nasianikolova/Cubi-2/README.md

# Cubi 2

**A SpaceInClass project designed by Athanasia (Nasia) Nikolova**

Cubi 2 is a self-balancing cube for the classroom. Three reaction wheels, one on each of three faces, and the battery sit inside a printed box; the box rides in a cage of 12 beams, with a rolling sphere around it. It is designed so that high-school students can build it and work with it to learn physics, mathematics, programming and space on a real machine.

Cubi 2 is designed in parametric code: one model makes the mechanical build, the three electronics boards, every cable and the printed documents. The numbers - dimensions, clearances, screws, inserts, print settings, weights - come from tests and from real builds and prints, not from theory alone.

This repository holds the **CAD files** (STEP and STL), the **build guides** (PDF) and the **Cubi 2 app** (code). The parametric model itself is not part of this repository.

> **This repository is a record of what was designed and built, not an instruction to build it.** Before you use anything here, read `DISCLAIMER.md` and `RESPECT.md`.

## Cubi 1 and Cubi 2

Cubi 2 grows out of Cubi 1, the first cube, built by a team at a space program in Sofia, 2026. The idea and the whole mechanical design of that cube are Athanasia Nikolova’s: she conceived it, designed it, made the CAD, 3D-printed every part, and assembled the cube, mounting the motors and the boards herself. Her teammates made the wiring and the electronics boards, wrote the software, and brought the cube into operation.

Cubi 1 brought the ideas that Cubi 2 keeps:

- the **open frame** - a cube made of edges only, open on every face;
- the **beams turned by 45 degrees**, like the roof beams of the old houses and the old Orthodox churches of Veria;
- the **reaction wheels**.

Cubi 2 adds:

- an **inner layout built around a perfect balance of the weight**, horizontally and vertically;
- the **gyroscope (IMU) and the battery on the vertical axis** - the main diagonal the cube balances on;
- **the routing of the cables**: every wire on its own road, in order, hidden under the boards;
- an attempt at **aesthetics alongside the engineering**.

## SpaceInClass

SpaceInClass is an initiative by Athanasia Nikolova. She first presented it at the **CASSINI Space Camp 2025** in Thessaloniki, Greece, where she and her team designed and assembled an 8U CubeSat model and planned its mission. The aim of SpaceInClass is to bring real space engineering into schools through *SpaceLabs*, where students build, program and operate their own hardware. Cubi 2 is one of the projects made for the SpaceLabs.

SpaceInClass is written entirely in English and is open to every school in the world. It is an independent initiative. It is not affiliated with or endorsed by the CASSINI Space Camp or its organizers.

### Why

> I want to bring knowledge into schools in a different way: more fun, with practical work while students learn the theory. I want to bring collaboration, so that already at school each of us can find the field they are good at. Students do not need to know everything. They can specialize, build teams and work together.
>
> Many children are bored in class. They cannot concentrate, they are not interested. Maybe I was like that once. Maybe these children are out there.
>
> I am waiting for ideas for more projects in SpaceInClass.
>
> - Athanasia Nikolova

## The original idea

Both Cubi 1 and Cubi 2 stand on the shoulders of the **Cubli**, the cube that can jump up and balance on a corner, created by scientists of the Institute for Dynamic Systems and Control at ETH Zurich, Switzerland. Their work showed that a cube with three reaction wheels can stand up by itself and balance on an edge or a corner. Cubi takes that idea into the classroom: printable, built by students, and designed with its own architecture.

- M. Gajamohan, M. Merz, I. Thommen, R. D'Andrea, *"The Cubli: A Cube That Can Jump up and Balance"*, IEEE/RSJ International Conference on Intelligent Robots and Systems (IROS), 2012, pp. 3722-3727.
- M. Gajamohan, M. Muehlebach, T. Widmer, R. D'Andrea, *"The Cubli: A Reaction Wheel Based 3D Inverted Pendulum"*, European Control Conference (ECC), 2013.

Cubi 2 is an independent project: it is not affiliated with or endorsed by the original authors or ETH Zurich.

## What has been tested

The printing, the assembly and the documentation of Cubi 2 have been tried out on real builds: the parts were printed, the cube was put together, and the guides were used to do it.

The operation has been tested too. In **29 recorded runs** on 22, 23 and 26 October 2026, Cubi 2 went from **1.4 seconds to 17.9 minutes** balancing on its corner. The 17.9-minute run was stopped by hand, with the cube still standing. Every run is kept in `Code/cubi2app/data/runs.json`.

The first tests of the **sphere** are done: it holds on its own and made a first short move.

The numbers in this repository come from those builds and tests, but they may still contain errors; check them against your own parts and printer.

### What the tests changed

- **The battery column.** The gyroscope (IMU) now sits inside a stiff plate, so the small moves of the battery no longer reach it.
- **The standoff at corner 0.** It broke when Cubi fell from my hands; the new one has ribs.
- **The hanging plate** (`CAD/Prints/hang_plate`). Cubi hangs from corner 0 and settles, and the app reads the new balance point.

### Next version

- The USB sockets of the boards reachable from outside the cube.
- A place for balance weights.

## A different direction: the sphere

The Cubli stands up by braking its wheels suddenly. **Cubi has no brakes.**

The first big change is the **sphere**. Cubi shifts the original purpose: it aims at **motion**, not only at standing up and balancing. The sphere is the perfect shape, and it is where I intend to experiment the most. **Cubi 2 has the sphere.**

## What I intend

This is a statement of intentions, not of results: I announce no discovery.

- I will **experiment** with the real cube and run **simulations** of it.
- The aim is to find out whether these ideas can be **useful in space applications**.
- Along the way, the research is meant to be a mix of **play, tests, failures, new knowledge from theory** - and perhaps a few successes.
- The project is planned to keep **students and STEM clubs** busy for **one academic year**.
- **SpaceInClass** will feature the good ideas that come out of this work on its page.

---

## What is where

```
CAD/
  Prints/      the parts that were PRINTED here - box, cage corners and beams,
               cover, reaction wheel, sphere arcs and connector, battery mounts,
               magnet carrier, cable clamps, standoffs, hanging plate
               (STEP and STL, as printed)
  Hardware/    what was BOUGHT and BUILT - motors, motor drivers, IMU, MCU board,
               battery connectors, spacers, and the three electronics boards
               that were soldered (STEP)
               SOURCES.txt = where each third-party model comes from + its license
Code/
  cubi2app/    the Cubi 2 app - Simulation and Live, in plain JavaScript
               (how to start it: Code/cubi2app/README.md)
Documents/     the build guides and the materials list (PDF), and the version history
```

The full assemblies (the whole cube, and the cube with all its cables) are larger than GitHub allows for one file (over 100 MB); they will be shared separately.

## How the documents are made

The build documents (parts lists and step-by-step guides) record how the cube was built here. Their layout and written text were produced with the help of artificial intelligence, working from the model and from the real builds; the mechanical design, the parametric model, the color system and the engineering decisions are my own. Care went into the teaching side of them:

- a **color code** that stays the same in every document - each board, wire and insert size has its own color, chosen so that students with low vision or color-blindness can tell them apart as well;
- **images and diagrams** drawn from the real 3D model, with real colors, so that what students see on paper is what they hold in their hands;
- one action per page, short steps and readable contrast, so that every student can follow them.

The aim is simple: to make the engineering **easier to understand** for students. The documents are reviewed, but they may contain mistakes - read them together with `DISCLAIMER.md`.

## Design rules

These are the rules the project follows, and the state the files are in:

- The **printed parts** in `CAD/Prints/` are the parts as printed; the parts in `CAD/Hardware/` keep their original colors.
- The **cage and the box are fixed**: they are already printed, so no later change moves them, not even by 0.001 mm.
- **Cables** run only on the cable roads: under the boards, along the three edges at corner 0, and on the sides of the corner-0 triangle. Power wires lie under the signal wires; no wire crosses another on a board; every wire gets under a board across a side, between that side's two standoffs.
- **Documents** have one action per page, real colors and readable contrast, also for low-vision students.
- Everything is in English.

## Units and frames

Millimeters; Corner 0 of the box is the origin; the three motor faces are x, y and z, with the wheels toward -x, -y and -z.

## License

Cubi 2 is **free for everyone**, as long as the name **Cubi 2** and its authors are credited.

- **Code** (the Cubi 2 app, and any code added to the project): **MIT** - see `LICENSE`.
- **CAD, drawings, documents, images**: **CC BY 4.0** - see `LICENSE-CAD.md`. Credit line: *Based on Cubi 2 by Athanasia Nikolova / SpaceInClass, CC BY 4.0.*
- **Third-party models** in `CAD/Hardware/` keep their own licenses - see `CAD/Hardware/SOURCES.txt`.

## Disclaimer, respect and safety

Cubi 2 is recorded for high-school students working **under the supervision of a teacher or mentor**.

- `DISCLAIMER.md` - no warranty, what the project is not, and who is responsible for what.
- `RESPECT.md` - how the project asks to be treated, and the safety note (battery, spinning wheels, soldering).

## Credits

Design: Athanasia Nikolova, for SpaceInClass.
