nasianikolova/Cubi-2/DISCLAIMER.md

# Disclaimer

Cubi 2 is an educational, open project by Athanasia Nikolova / SpaceInClass. This page explains what the project is, what it is not, and who is responsible for what. It does not replace the licenses (`LICENSE`, `LICENSE-CAD.md`); where anything here and the licenses differ, the licenses apply.

## No warranty

Everything in this repository — CAD files, drawings, documents, images and code — is provided **"as is", without warranty of any kind**, express or implied, including fitness for a particular purpose. To the extent permitted by law, the author is **not liable** for any damage, injury, loss or cost arising from the use, misuse or inability to use this material, whether or not it was built or used as described.

## A record, not an instruction

This repository **shows what was designed, printed and built**. It is a record and an example, not an invitation, a recommendation or an instruction to anyone to reproduce it.

- Nothing here tells you to build a Cubi 2, to buy any component, to use any battery, tool, material or setting, or to carry out any step.
- The steps in the build documents describe **how it was done here**, with these parts, this printer and this filament, under supervision. They are not a direction to do the same, and they are not a claim that doing the same is safe.
- The decision to build, charge, power or operate anything based on this material is taken **freely and independently** by the person who builds it — and, where students are involved, by the supervising adult, school or organization. That decision, and everything that follows from it, is theirs.
- Where a step would be unsafe in your setting, with your parts or with your students: **do not do it.** Your own judgment, and the rules of your school and country, come before anything written here.

## What Cubi 2 is not

- **Not a certified or finished product.** It is not CE marked, not tested against any safety or EMC standard, and not approved for sale, hire or distribution as a product.
- **Not a toy.** It is a teaching machine, recorded for high-school students working **under the supervision of a teacher or mentor**.
- **Not space-qualified.** The project explores ideas that may one day be useful in space applications; nothing here is flight hardware or validated for space, and no such claim is made.
- **Not a scientific result.** The section "What I intend" in the README is a statement of intentions. No discovery is announced and no performance is promised.

## Build status

Printing, assembly and the build documents have been tried on real builds. The **operation** has been tested in 29 recorded runs (October 2026), the longest 17.9 minutes; these are tests of one cube, not a guarantee for another. Dimensions, clearances, screw and insert sizes, print settings and weights come from tests and real builds, but they **may still contain errors**. Check every number against your own parts, printer and materials before you rely on it.

Parts of the build documents are produced with the help of **artificial intelligence**. They are reviewed, but they may contain mistakes. Treat them as a record, not as an authority.

## Safety and responsibility

The safety notes in `RESPECT.md` are a summary, not a complete risk assessment. Cubi 2 involves a **6S lithium-polymer battery**, **fast spinning reaction wheels**, **soldering at high temperature**, **strong magnets**, **adhesives** and **carbon-fiber filament**. These can cause fire, burns, cuts, crushing, eye damage and inhalation of harmful particles.

- The person who builds, charges, powers or operates a Cubi 2 — and, for students, the **supervising adult, school or organization** — carries full responsibility for safe working, risk assessment, supervision, protective equipment, insurance and compliance with local rules and school policy.
- Anyone using this material must have, or be supervised by someone who has, the skills to judge whether a step is safe in their own setting.
- The supervising adult decides what each student may do.

## Third-party work

- Models in `CAD/Hardware/` come from third parties and **keep their own licenses** — see `CAD/Hardware/SOURCES.txt`. No warranty is given for their accuracy or for their fitness for this build.
- Bought components (motors, drivers, IMU, MCU board, battery, fasteners) are the responsibility of their own manufacturers. Follow their datasheets and safety instructions; where they differ from this project's documents, the manufacturer's instructions apply.

## No affiliation or endorsement

Cubi 2 is an independent project. It is **not affiliated with, sponsored by or endorsed by** ETH Zurich, the authors of the Cubli, the CASSINI Space Camp or its organizers, or any component manufacturer, institution or program named in this repository. Names are mentioned for credit and reference only.

## Changes and forks

Anyone who modifies, redistributes or builds on Cubi 2 is responsible for their own version. Please say clearly what you changed, so that no one confuses your version with the original or holds the original responsible for it. Nothing in this project implies that a modified version is safe or correct.

## Students' work

Builds, code, photos and results made by students belong to them. Nothing here claims rights over student work, and student names are published only with their permission and, for minors, their guardians' permission.

## Contact

Mistakes and safety concerns are welcome: please open an issue in this repository. They will be corrected as soon as possible, but no response time is guaranteed.

---

*Design and project: Athanasia Nikolova, for SpaceInClass.*
