nasianikolova/Cubi-2/CAD/Hardware/perfboard.STEP

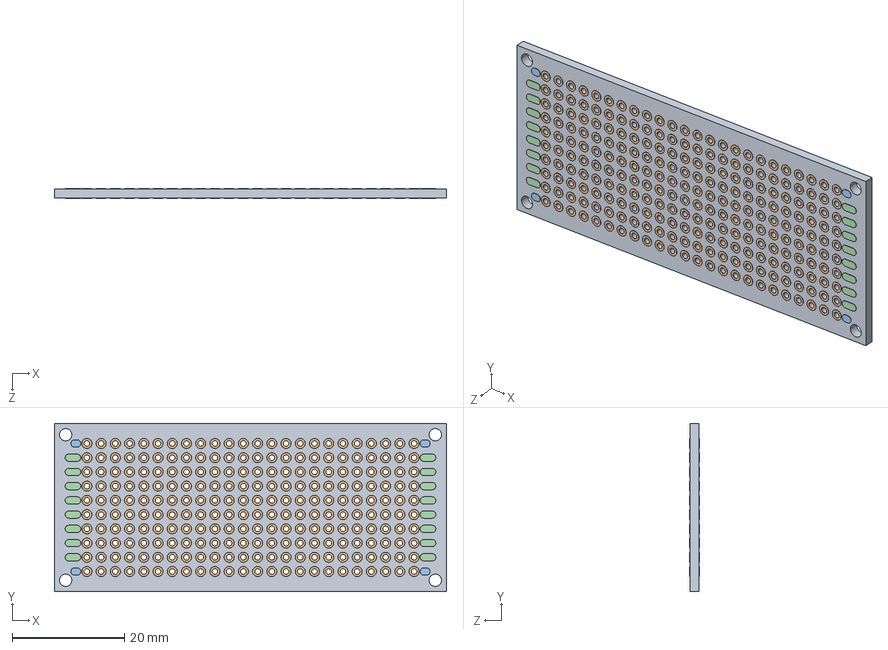
[picture p3: CAD file, 2026-10-29]
CAD/Hardware/perfboard.STEP
70.0 x 30.0 x 1.70 mm
fr4
rings_top
endpad_top_0
endpad_top_1
endpad_top_2
endpad_top_3
endpad_top_4
endpad_top_5
endpad_top_6
endpad_top_7
endpad_top_8
endpad_top_9
endpad_top_10
endpad_top_11
endpad_top_12
endpad_top_13
endpad_top_14
endpad_top_15
endpad_top_16
endpad_top_17
endpad_top_18
endpad_top_19
rings_bot
endpad_bot_0
endpad_bot_1
endpad_bot_2
endpad_bot_3
endpad_bot_4
endpad_bot_5
endpad_bot_6
endpad_bot_7
endpad_bot_8
endpad_bot_9
endpad_bot_10
endpad_bot_11
endpad_bot_12
endpad_bot_13
endpad_bot_14
endpad_bot_15
endpad_bot_16
endpad_bot_17
endpad_bot_18
endpad_bot_19
