nasianikolova/Cubi-2/CAD/Prints/hang_plate.STEP

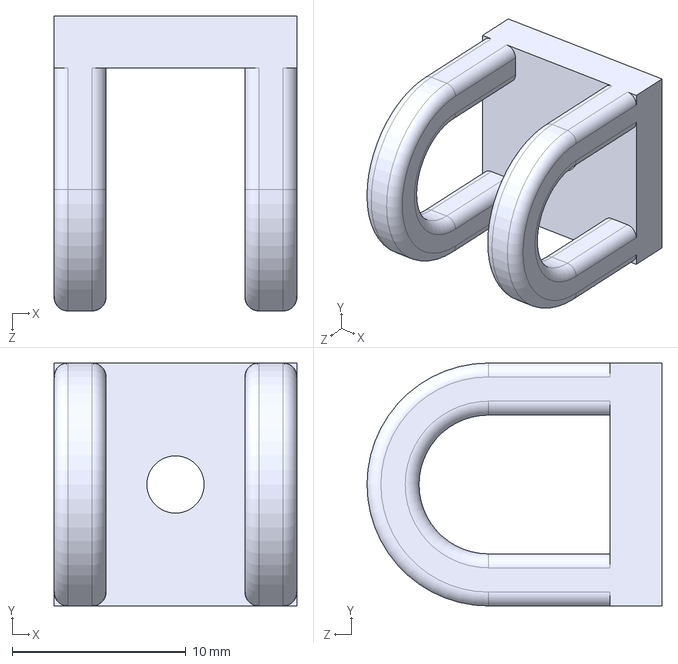
[picture p4: CAD file, 2026-10-30]
CAD/Prints/hang_plate.STEP
14.0 x 14.0 x 17.0 mm
