nasianikolova/Cubi-2/CAD/Hardware/motor_driver.STEP

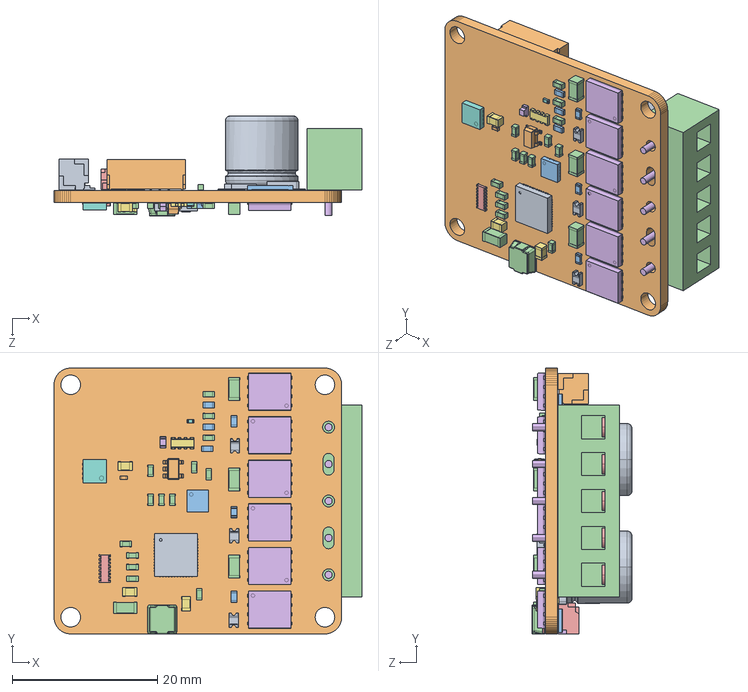
[picture p5: CAD file, 2026-10-29]
CAD/Hardware/motor_driver.STEP
42.4 x 36.6 x 13.8 mm
