nasianikolova/Cubi-2/CAD/Prints/reaction_wheel.STEP

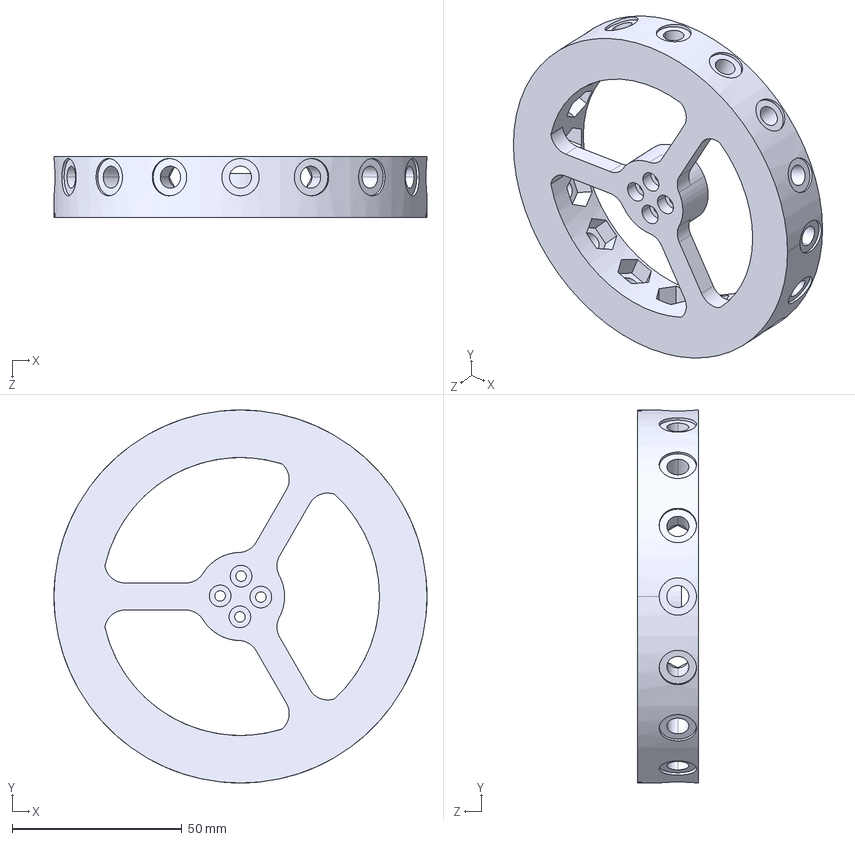
[picture p6: CAD file, 2026-10-30]
CAD/Prints/reaction_wheel.STEP
110.0 x 110.0 x 18.0 mm
