nasianikolova/Cubi-2/CAD/Hardware/motor.STEP

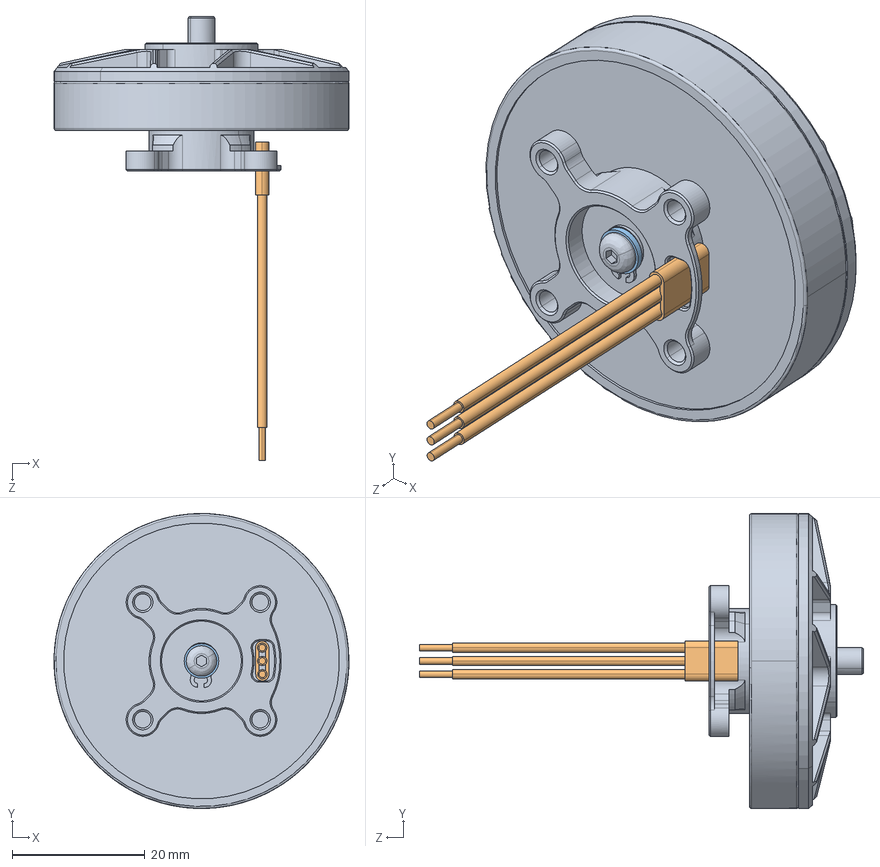
[picture p7: CAD file, 2026-10-29]
CAD/Hardware/motor.STEP
44.4 x 44.4 x 66.9 mm
leads
lead_exit_1
