nasianikolova/Cubi-2/CAD/Prints/battery_basin.STEP

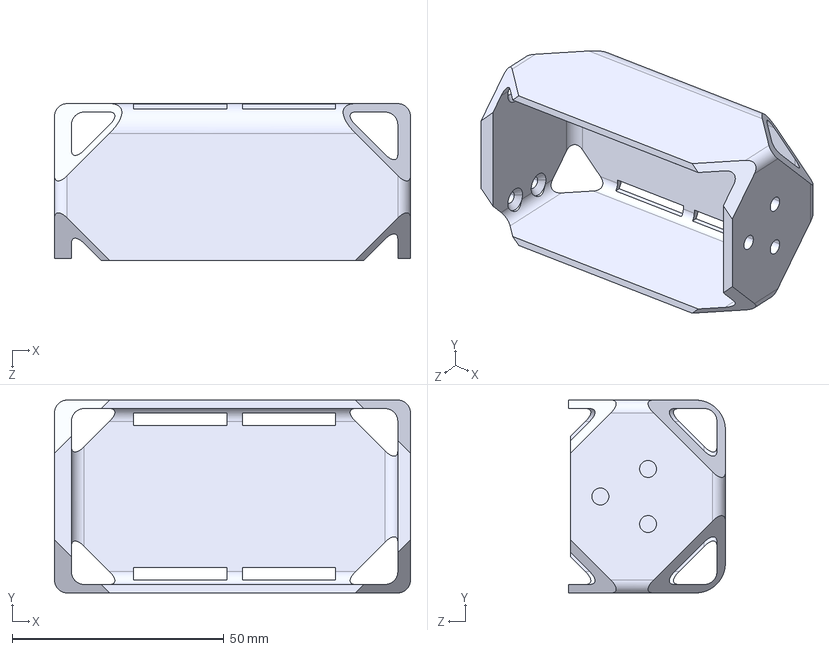
[picture p8: CAD file, 2026-10-30]
CAD/Prints/battery_basin.STEP
84.0 x 45.5 x 37.0 mm
