nasianikolova/Cubi-2/CAD/Hardware/mcu.STEP

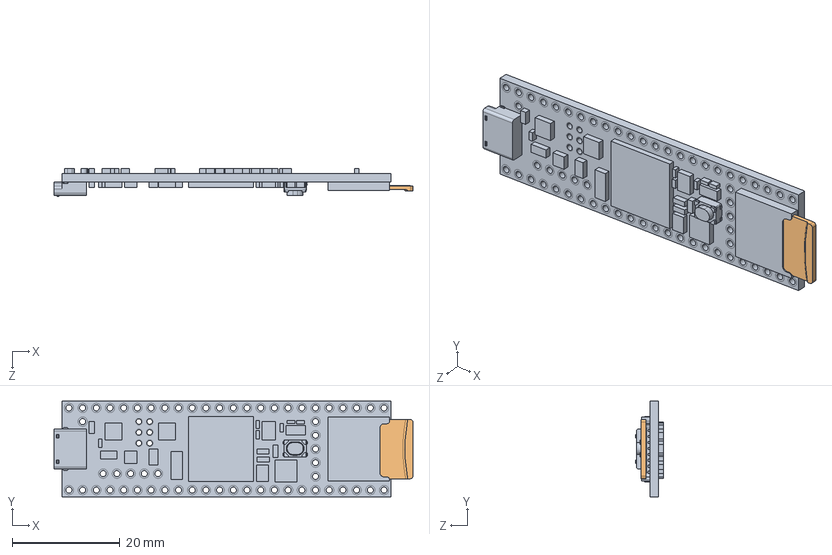
[picture p9: CAD file, 2026-10-29]
CAD/Hardware/mcu.STEP
66.6 x 17.8 x 5.27 mm
