nasianikolova/Cubi-2/CAD/Prints/clamp_x_2_base.STEP

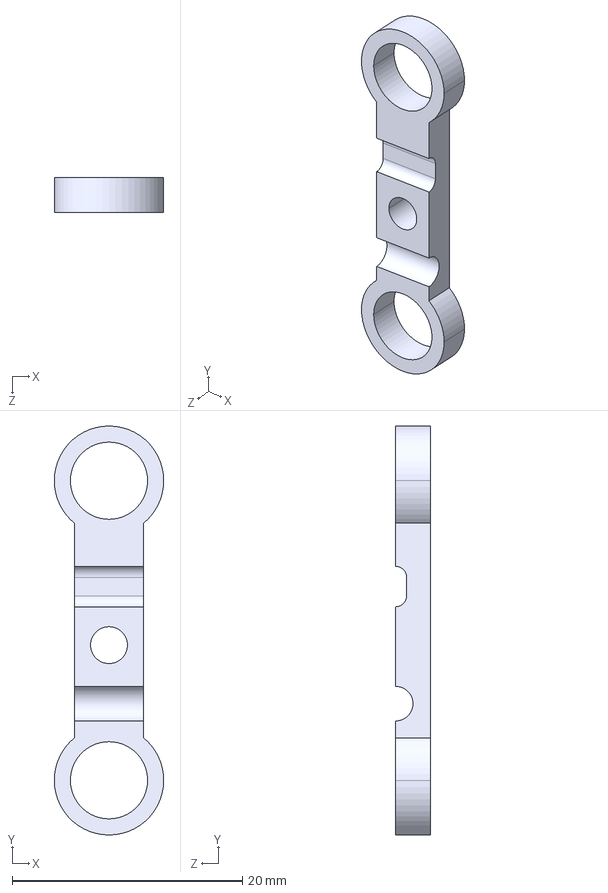
[picture p10: CAD file, 2026-10-30]
CAD/Prints/clamp_x_2_base.STEP
9.50 x 35.5 x 3.00 mm
