nasianikolova/Cubi-2/CAD/Hardware/imu.STEP

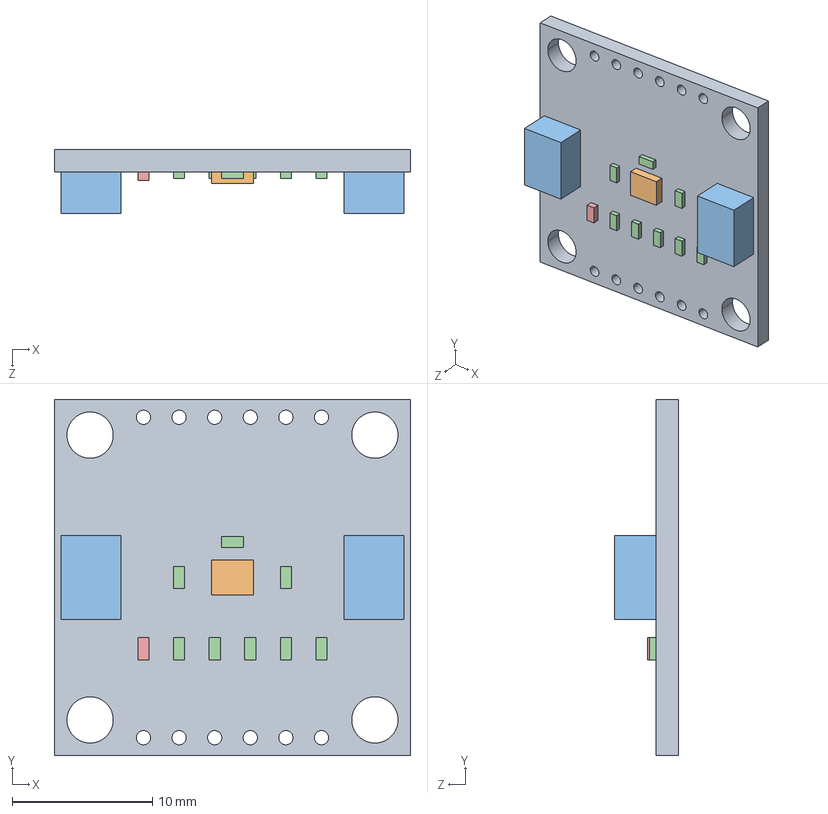
[picture p11: CAD file, 2026-10-29]
CAD/Hardware/imu.STEP
25.4 x 25.4 x 4.55 mm
pcb
U1_imu
J1_i2c
J2_i2c
R1
R2
R3
R4
R5
R6
C1
C2
D1
