nasianikolova/Cubi-2/CAD/Prints/navel.step

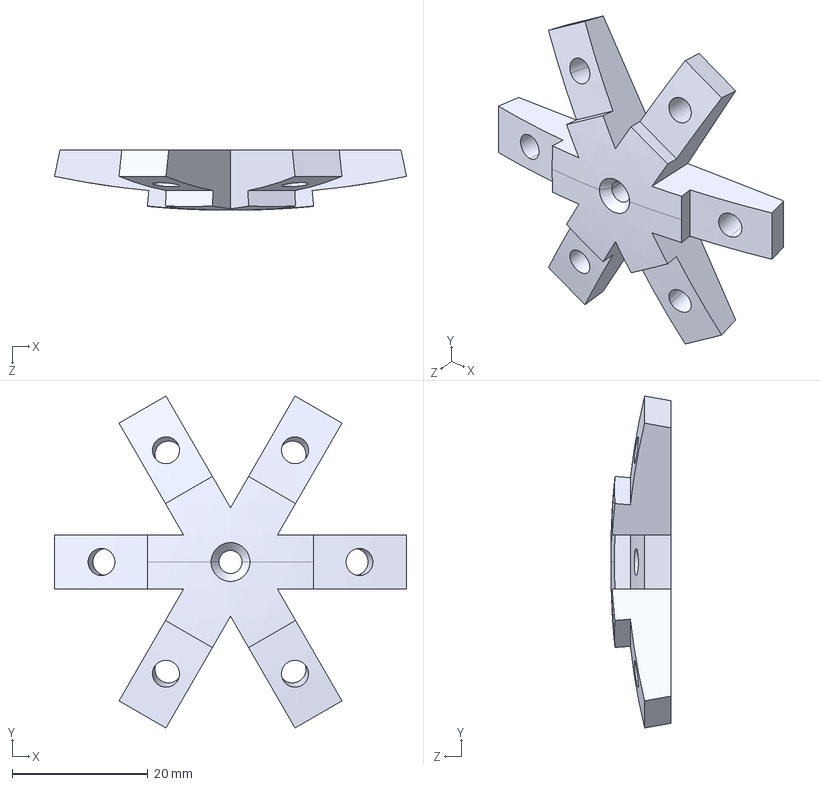
[picture p12: CAD file, 2026-10-30]
CAD/Prints/navel.step
51.9 x 49.0 x 8.90 mm
