nasianikolova/Cubi-2/CAD/Hardware/bconn_male.STEP

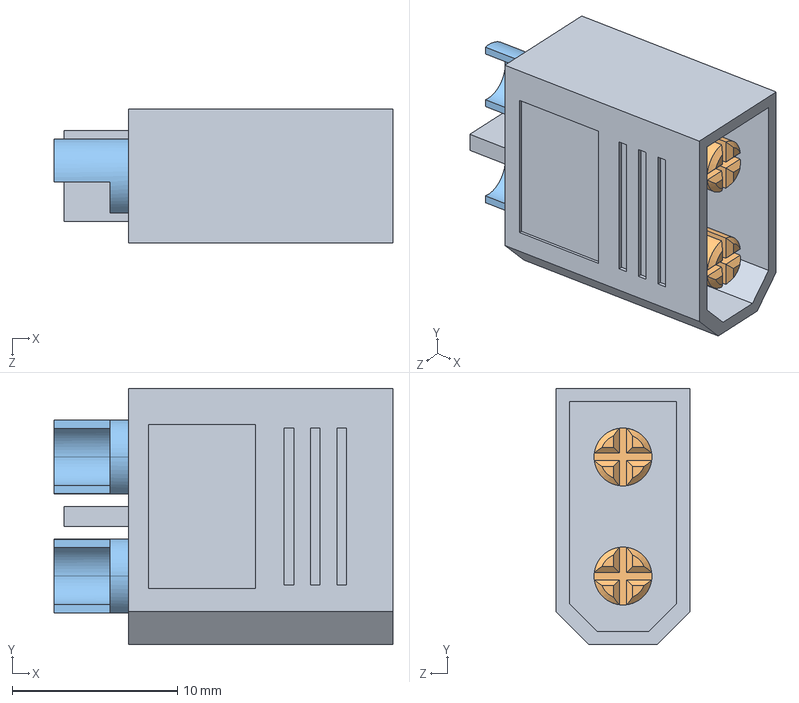
[picture p13: CAD file, 2026-10-29]
CAD/Hardware/bconn_male.STEP
20.5 x 15.5 x 8.10 mm
bconn_male_housing
bconn_male_gold_1
bconn_male_gold_2
bconn_male_gold_3
bconn_male_gold_4
