nasianikolova/Cubi-2/CAD/Prints/box_standoff.STEP

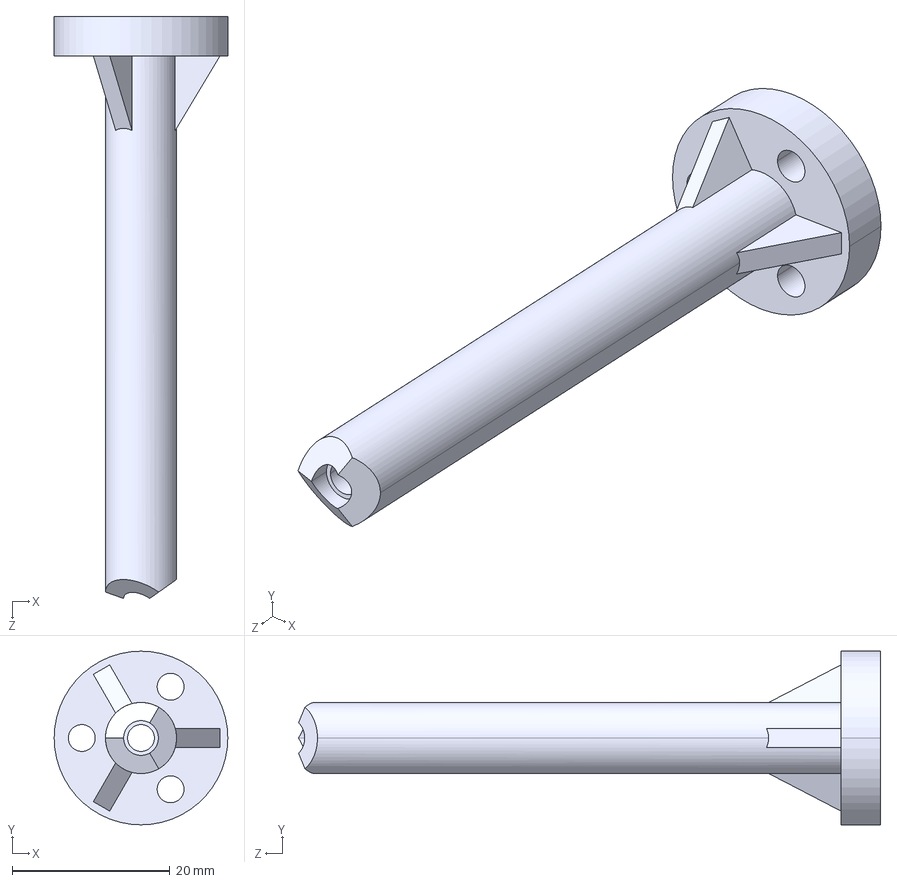
[picture p14: CAD file, 2026-10-30]
CAD/Prints/box_standoff.STEP
22.0 x 22.0 x 73.7 mm
