nasianikolova/Cubi-2/CAD/Hardware/bconn_female.STEP

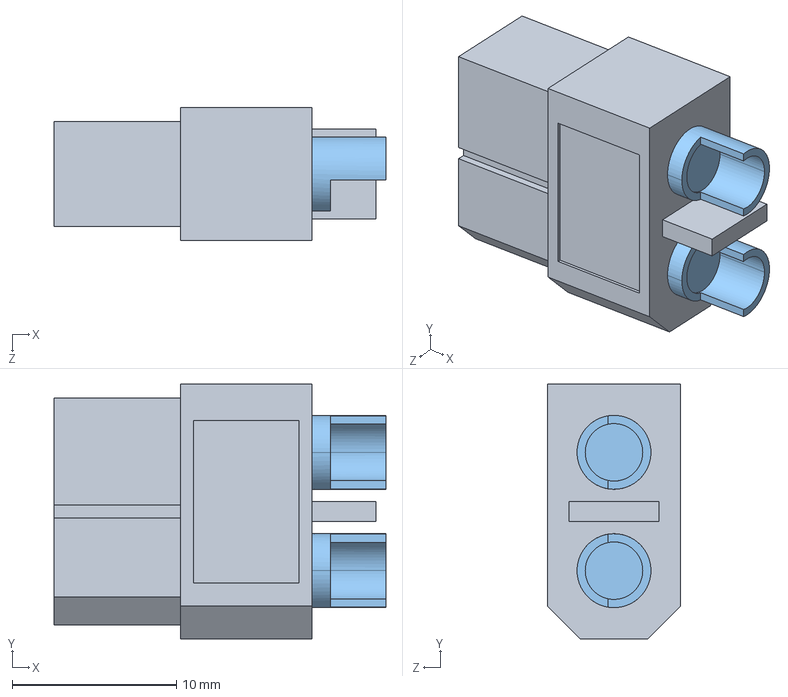
[picture p15: CAD file, 2026-10-29]
CAD/Hardware/bconn_female.STEP
20.2 x 15.5 x 8.10 mm
bconn_female_housing
bconn_female_gold_1
bconn_female_gold_2
bconn_female_gold_3
bconn_female_gold_4
