nasianikolova/Cubi-2/CAD/Prints/spacer_OD6_ID3.2_H4.STEP

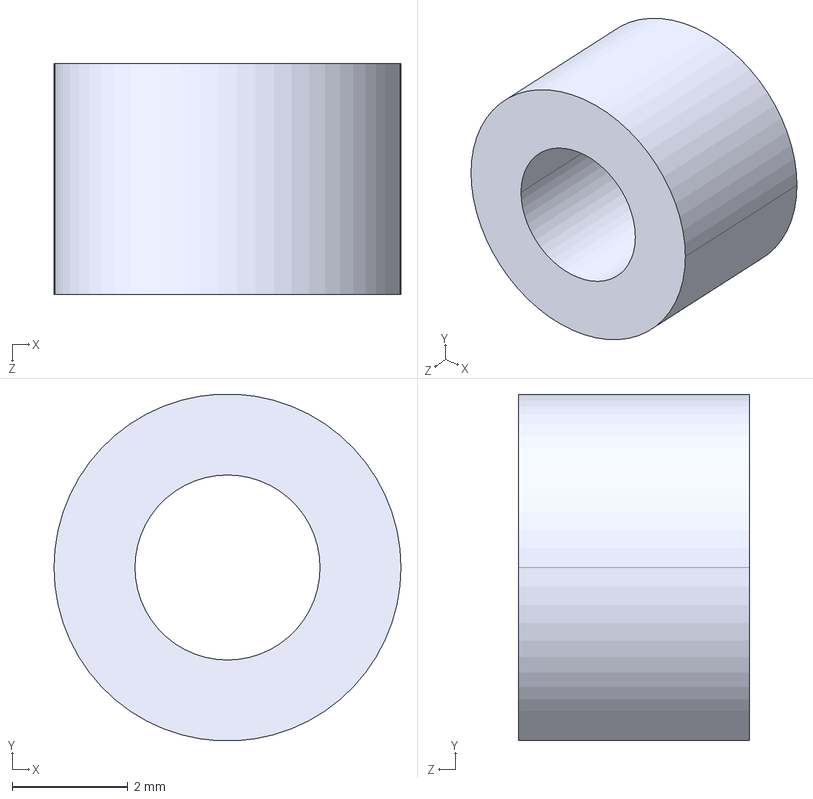
[picture p16: CAD file, 2026-10-30]
CAD/Prints/spacer_OD6_ID3.2_H4.STEP
6.00 x 5.99 x 4.00 mm
