nasianikolova/Cubi-2/CAD/Hardware/board_x.STEP

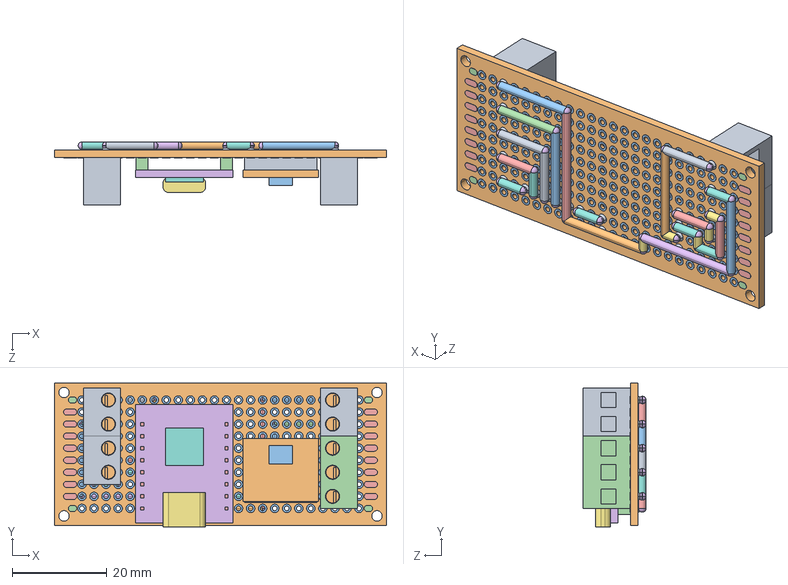
[picture p17: CAD file, 2026-10-29]
CAD/Hardware/board_x.STEP
70.0 x 30.3 x 13.4 mm
tb_w1_0
tb_w1_1
tb_w1_2
tb_w1_3
tb_w1_4
tb_w2_0
tb_w2_1
tb_w2_2
tb_w2_3
tb_w2_4
wifi_0
wifi_1
wifi_2
wifi_3
wifi_4
wifi_5
wifi_6
wifi_7
wifi_8
wifi_9
wifi_10
wifi_11
wifi_12
wifi_13
wifi_14
wifi_15
wifi_16
wifi_17
wifi_18
wifi_19
wifi_20
cantr_0
cantr_1
cantr_2
cantr_3
cantr_4
cantr_5
cantr_6
cantr_7
cantr_8
tb_e1_0
tb_e1_1
tb_e1_2
tb_e1_3
tb_e1_4
tb_e1_5
tb_e1_6
tb_e2_0
tb_e2_1
tb_e2_2
tb_e2_3
tb_e2_4
wire_0
wire_1
wire_2
wire_3
wire_4
wire_5
wire_6
wire_7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
