nasianikolova/Cubi-2/CAD/Prints/beam_tie.STEP

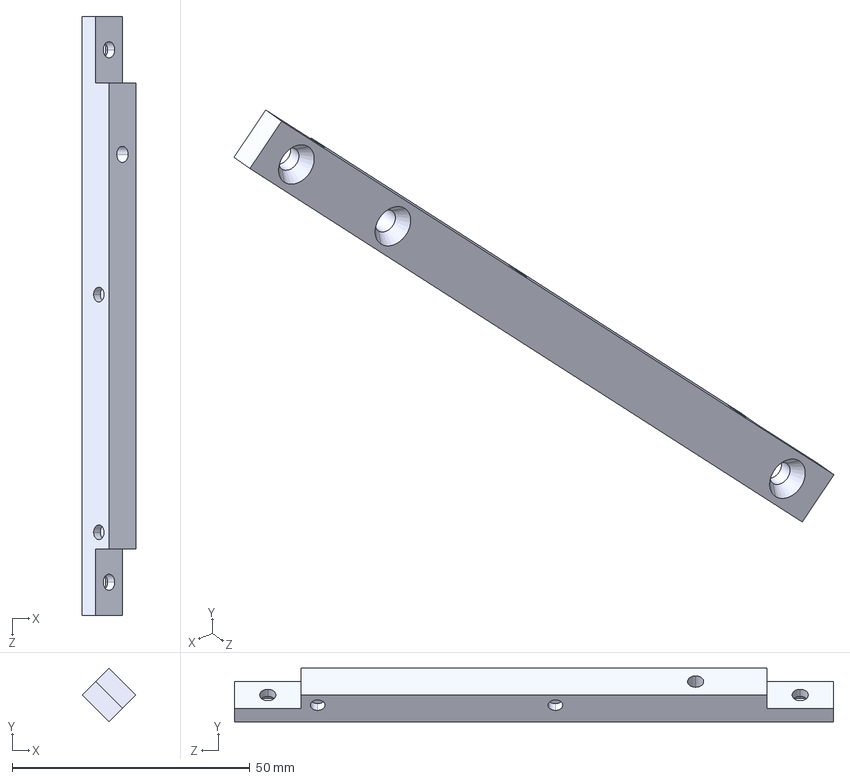
[picture p18: CAD file, 2026-10-30]
CAD/Prints/beam_tie.STEP
11.3 x 11.3 x 126.0 mm
