nasianikolova/Cubi-2/CAD/Hardware/board_y.STEP

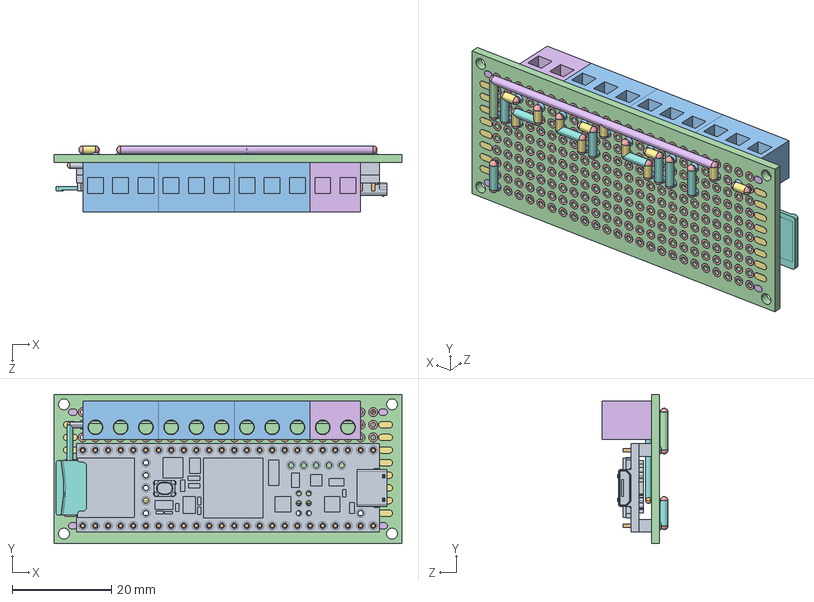
[picture p19: CAD file, 2026-10-29]
CAD/Hardware/board_y.STEP
70.0 x 30.0 x 13.4 mm
mcu_1
mcu_2
mcu_3
mcu_4
mcu_5
mcu_6
mcu_7
mcu_8
mcu_9
mcu_10
mcu_11
mcu_12
mcu_13
mcu_14
mcu_15
mcu_16
mcu_17
mcu_18
mcu_19
mcu_20
mcu_21
mcu_22
mcu_23
mcu_24
mcu_25
mcu_26
mcu_27
mcu_28
mcu_29
mcu_30
mcu_31
mcu_32
mcu_33
mcu_34
mcu_35
mcu_36
mcu_37
mcu_38
mcu_39
mcu_40
mcu_41
mcu_42
mcu_43
mcu_44
mcu_45
mcu_46
mcu_47
mcu_48
mcu_49
mcu_50
tb_a_0
tb_a_1
tb_a_2
tb_a_3
tb_a_4
tb_a_5
tb_a_6
tb_b_0
tb_b_1
tb_b_2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
