nasianikolova/Cubi-2/CAD/Prints/spacer_OD6_ID3.2_H1.step

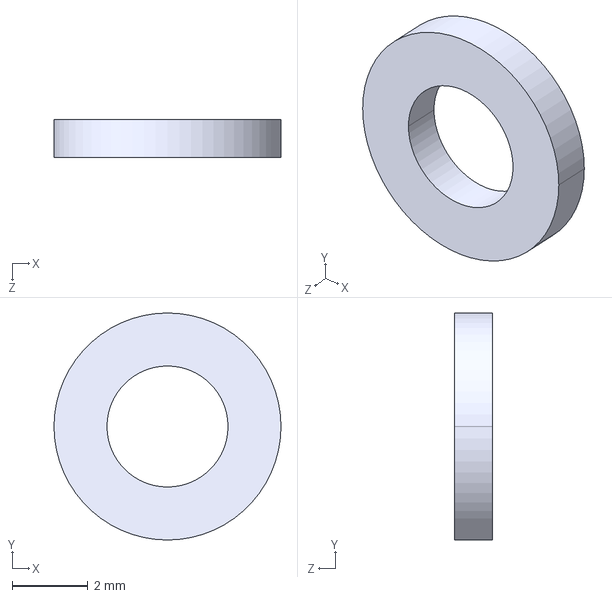
[picture p20: CAD file, 2026-10-30]
CAD/Prints/spacer_OD6_ID3.2_H1.step
6.00 x 6.00 x 1.00 mm
