nasianikolova/Cubi-2/CAD/Hardware/board_z.STEP

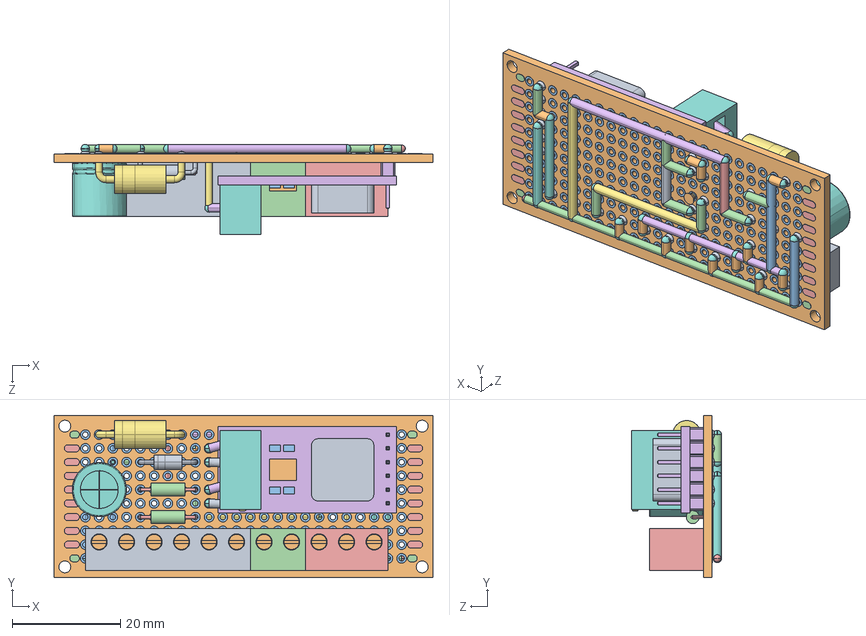
[picture p21: CAD file, 2026-10-18]
CAD/Hardware/board_z.STEP
70.0 x 30.0 x 16.7 mm
tb_mot_6p_0
tb_mot_6p_1
tb_mot_6p_2
tb_mot_6p_3
tb_mot_6p_4
tb_mot_6p_5
tb_mot_6p_6
tb_mot_6p_7
tb_mot_6p_8
tb_mot_6p_9
tb_mot_6p_10
tb_mot_6p_11
tb_mot_6p_12
tb_batt_0
tb_batt_1
tb_batt_2
tb_batt_3
tb_batt_4
tb_out_3p_0
tb_out_3p_1
tb_out_3p_2
tb_out_3p_3
tb_out_3p_4
tb_out_3p_5
tb_out_3p_6
dcdc_1_0
dcdc_1_2
dcdc_1_3
dcdc_1_4
dcdc_1_5
dcdc_1_6
dcdc_1_7
dcdc_1_8
dcdc_1_9
dcdc_1_10
dcdc_1_11
dcdc_1_12
r_100k_0
r_100k_1
r_10k_0
r_10k_1
dcdc_drop_0
dcdc_drop_1
dcdc_drop_2
dcdc_drop_3
dcdc_drop_4
dcdc_drop_5
dcdc_drop_6
dcdc_drop_7
dcdc_drop_8
dcdc_drop_9
dcdc_drop_10
dcdc_drop_11
dcdc_drop_12
wire_0
wire_1
wire_2
wire_3
wire_4
wire_5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
