nasianikolova/Cubi-2/CAD/Prints/magnet_carrier.STEP

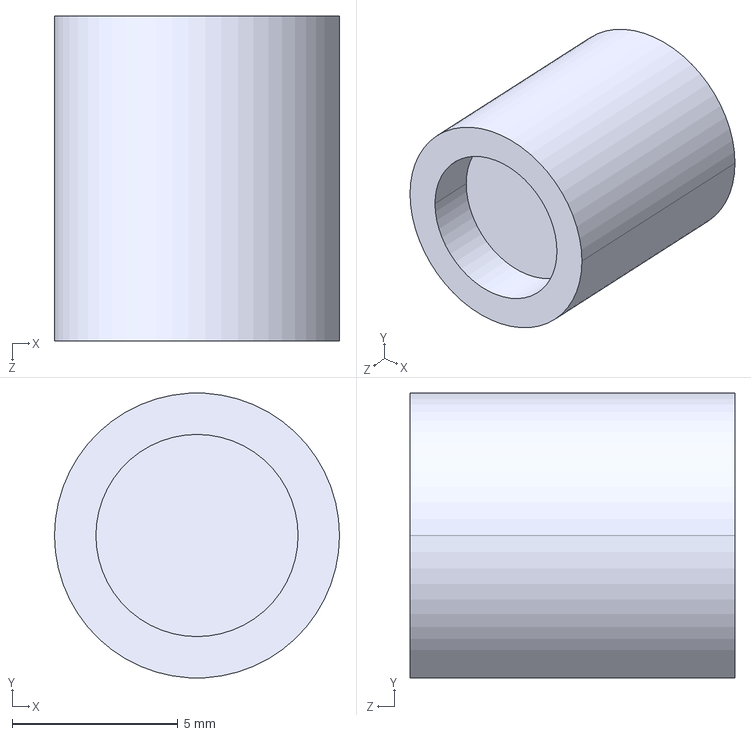
[picture p22: CAD file, 2026-10-30]
CAD/Prints/magnet_carrier.STEP
8.60 x 8.59 x 9.80 mm
