nasianikolova/Cubi-2/CAD/Prints/cover.step

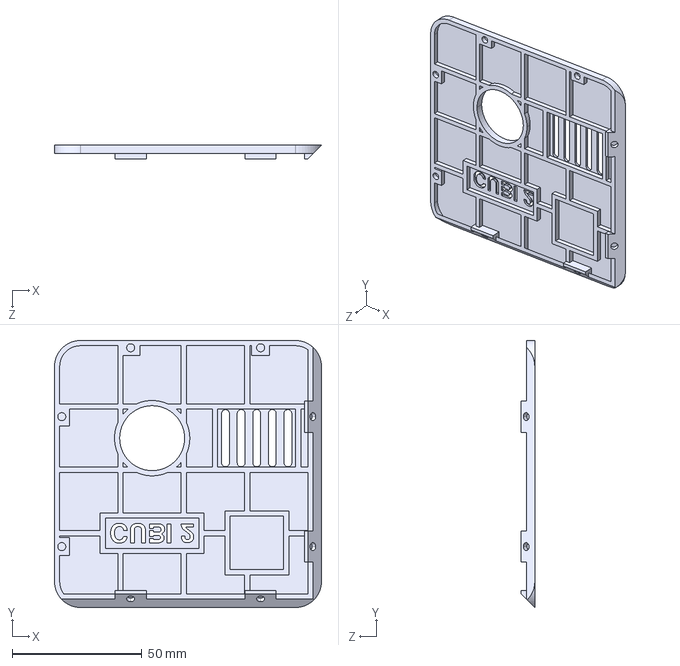
[picture p23: CAD file, 2026-10-30]
CAD/Prints/cover.step
102.7 x 102.7 x 5.23 mm
