nasianikolova/Cubi-2/CAD/Prints/clamp_z_base.STEP

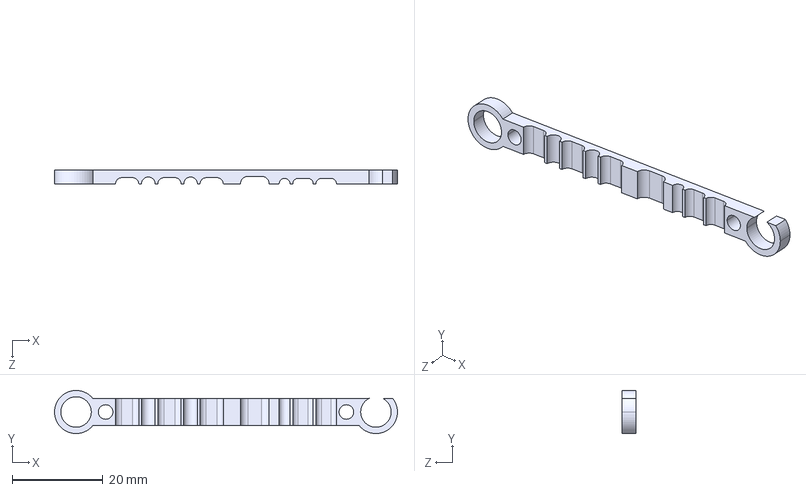
[picture p24: CAD file, 2026-10-30]
CAD/Prints/clamp_z_base.STEP
75.5 x 9.50 x 3.00 mm
