nasianikolova/Cubi-2/CAD/Prints/clamp_power.STEP

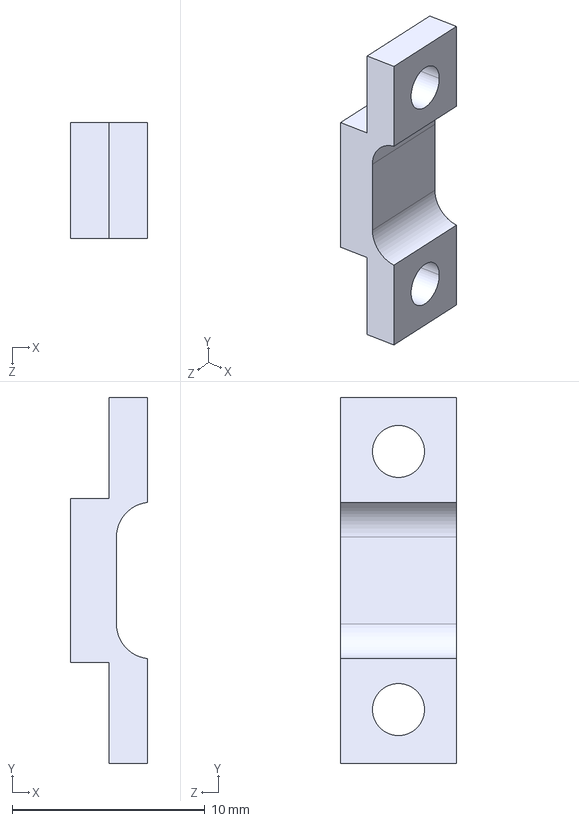
[picture p26: CAD file, 2026-10-30]
CAD/Prints/clamp_power.STEP
4.00 x 19.0 x 6.00 mm
