nasianikolova/Cubi-2/CAD/Prints/clamp_y.step

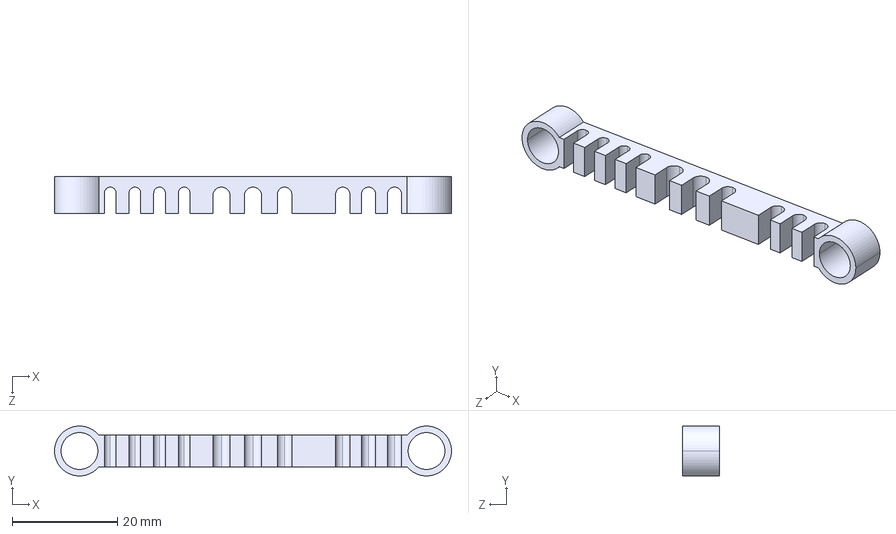
[picture p27: CAD file, 2026-10-30]
CAD/Prints/clamp_y.step
75.5 x 9.50 x 7.00 mm
