nasianikolova/Cubi-2/CAD/Prints/base_top.STEP

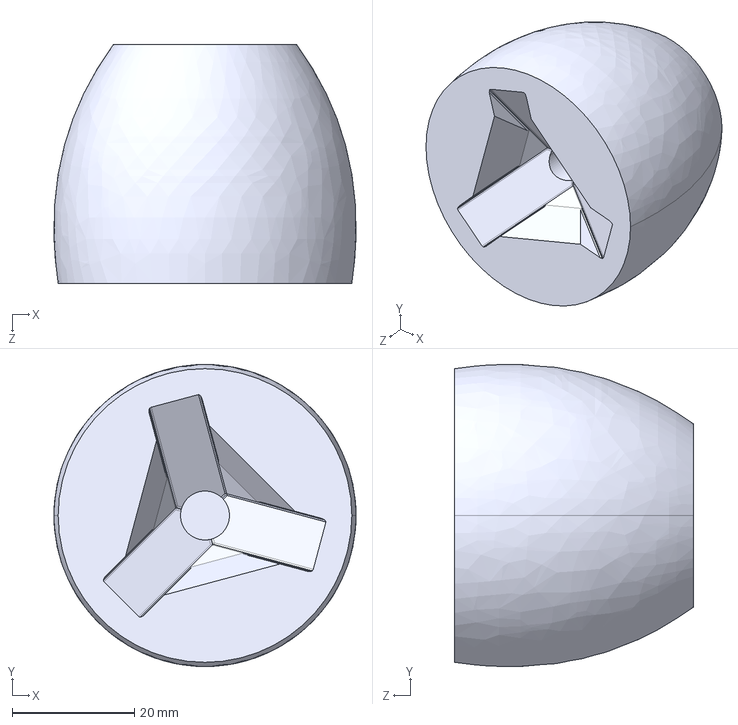
[picture p28: CAD file, 2026-10-30]
CAD/Prints/base_top.STEP
49.4 x 49.4 x 39.0 mm
