nasianikolova/Cubi-2/CAD/Prints/clamp_x_1_top.STEP

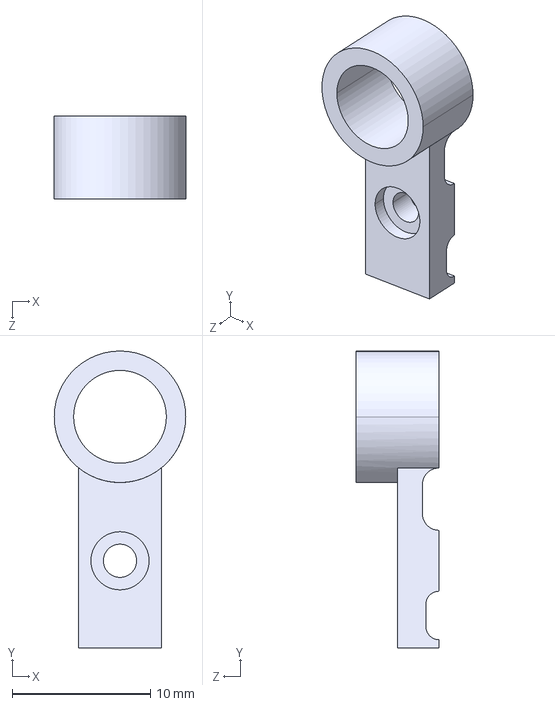
[picture p29: CAD file, 2026-10-30]
CAD/Prints/clamp_x_1_top.STEP
9.50 x 21.4 x 6.00 mm
