nasianikolova/Cubi-2/CAD/Prints/spacer_OD9.5_ID7_H2.step

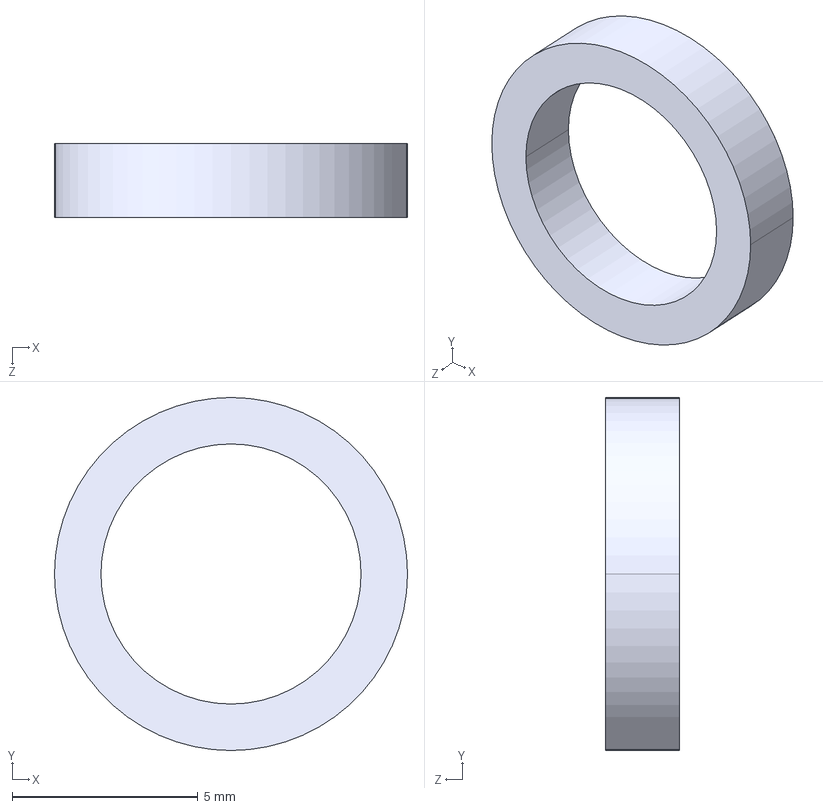
[picture p30: CAD file, 2026-10-30]
CAD/Prints/spacer_OD9.5_ID7_H2.step
9.50 x 9.50 x 2.00 mm
