nasianikolova/Cubi-2/CAD/Prints/base_top_sphere.STEP

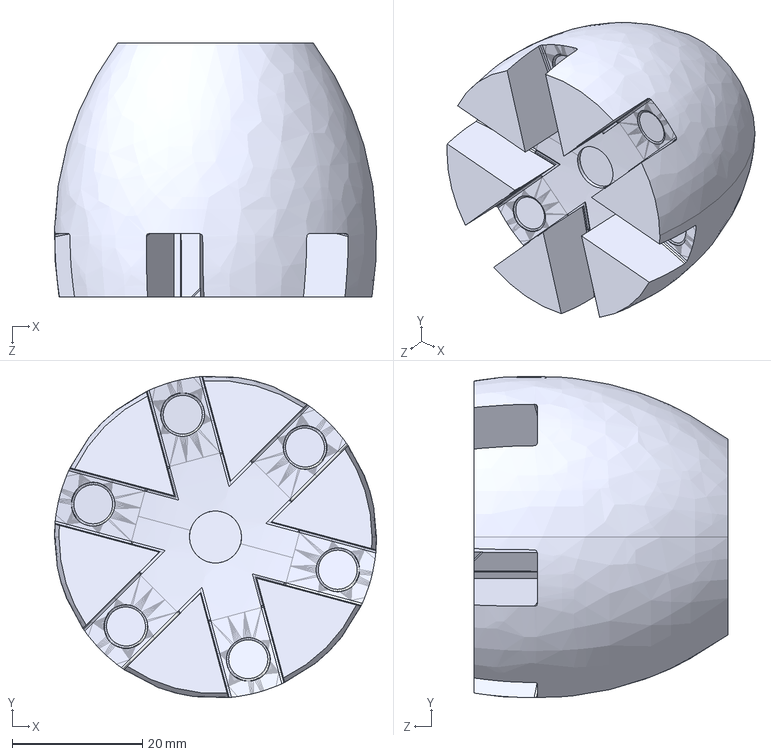
[picture p31: CAD file, 2026-10-30]
CAD/Prints/base_top_sphere.STEP
49.4 x 49.3 x 39.0 mm
