nasianikolova/Cubi-2/CAD/Prints/corner_b.STEP

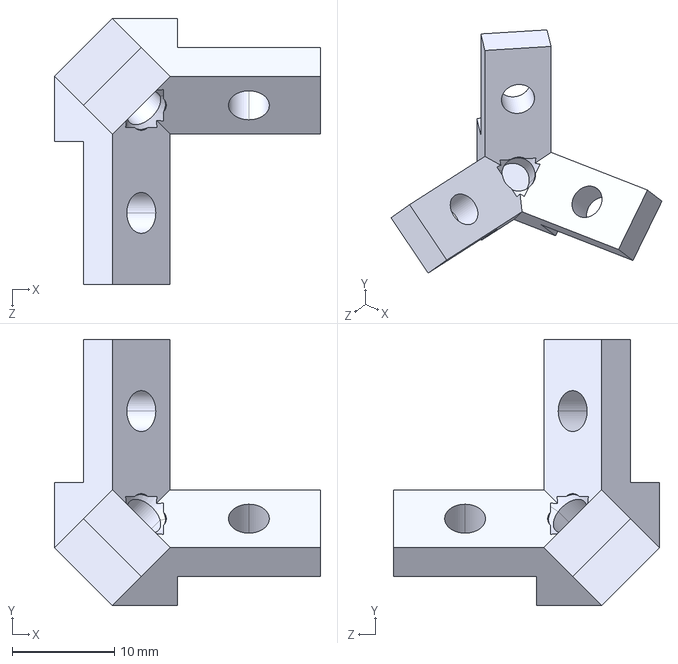
[picture p32: CAD file, 2026-10-30]
CAD/Prints/corner_b.STEP
26.0 x 26.0 x 26.0 mm
