nasianikolova/Cubi-2/CAD/Prints/sphere_arc_edge.STEP

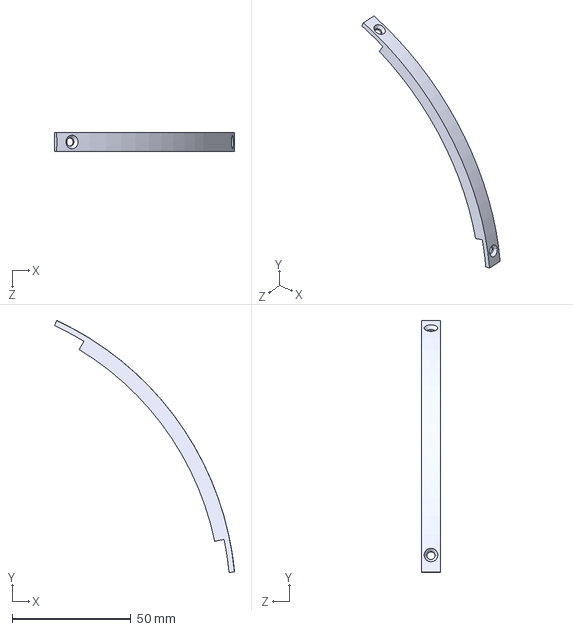
[picture p33: CAD file, 2026-10-30]
CAD/Prints/sphere_arc_edge.STEP
75.7 x 105.9 x 8.00 mm
