nasianikolova/Cubi-2/CAD/Prints/base_bottom.STEP

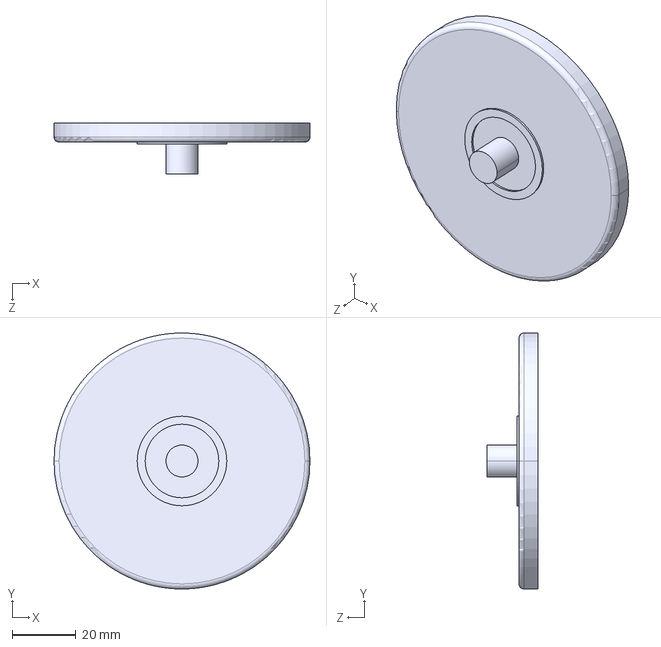
[picture p34: CAD file, 2026-10-30]
CAD/Prints/base_bottom.STEP
80.0 x 80.0 x 16.0 mm
