nasianikolova/Cubi-2/CAD/Prints/clamp_z_top.STEP

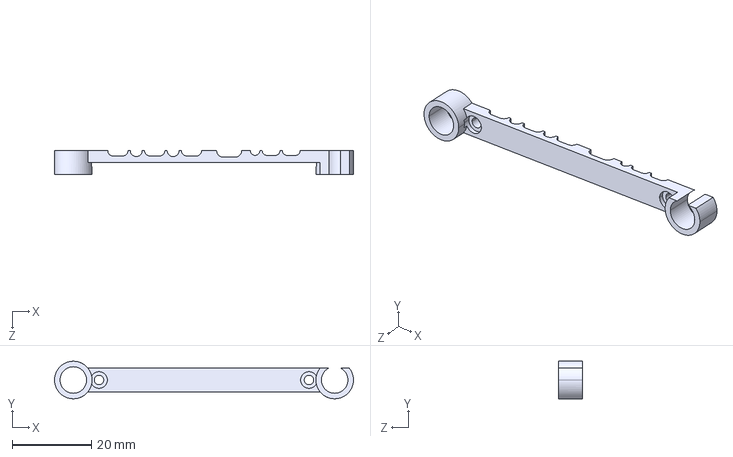
[picture p35: CAD file, 2026-10-30]
CAD/Prints/clamp_z_top.STEP
75.5 x 9.50 x 6.00 mm
