nasianikolova/Cubi-2/CAD/Prints/box.STEP

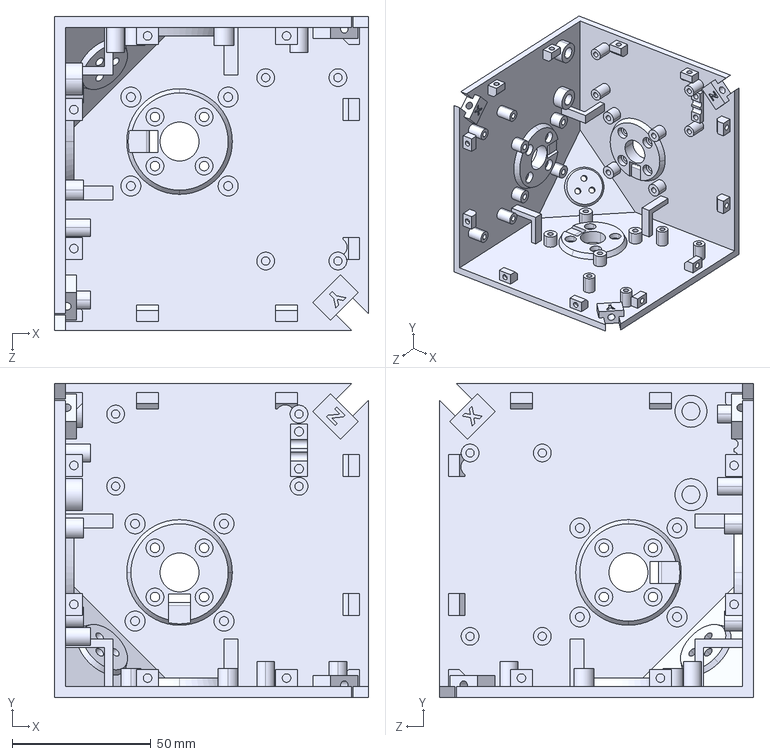
[picture p36: CAD file, 2026-10-30]
CAD/Prints/box.STEP
113.0 x 113.0 x 113.0 mm
