nasianikolova/Cubi-2/CAD/Prints/sphere_arc_diag_over.step

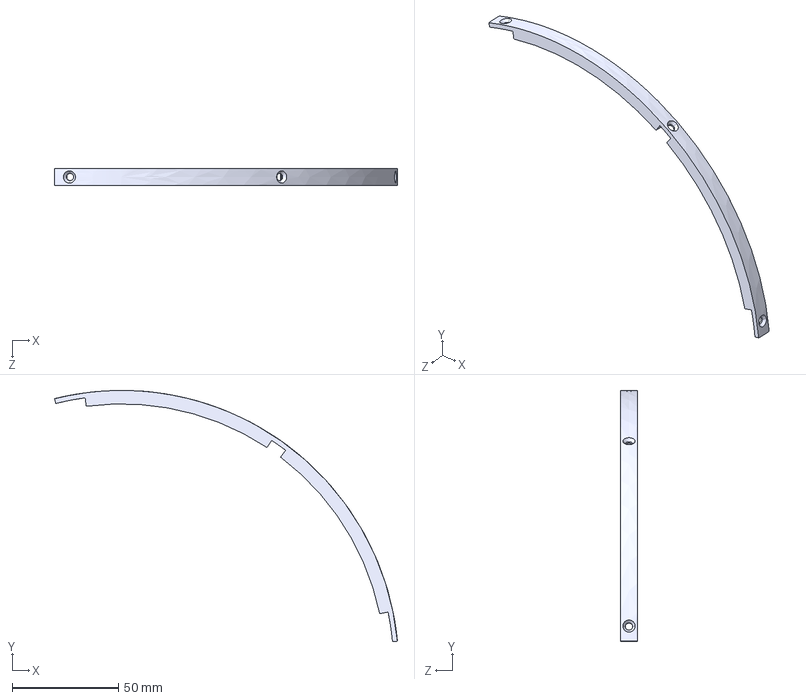
[picture p37: CAD file, 2026-10-30]
CAD/Prints/sphere_arc_diag_over.step
161.1 x 118.0 x 8.00 mm
