nasianikolova/Cubi-2/CAD/Prints/clamp_x_2_top.STEP

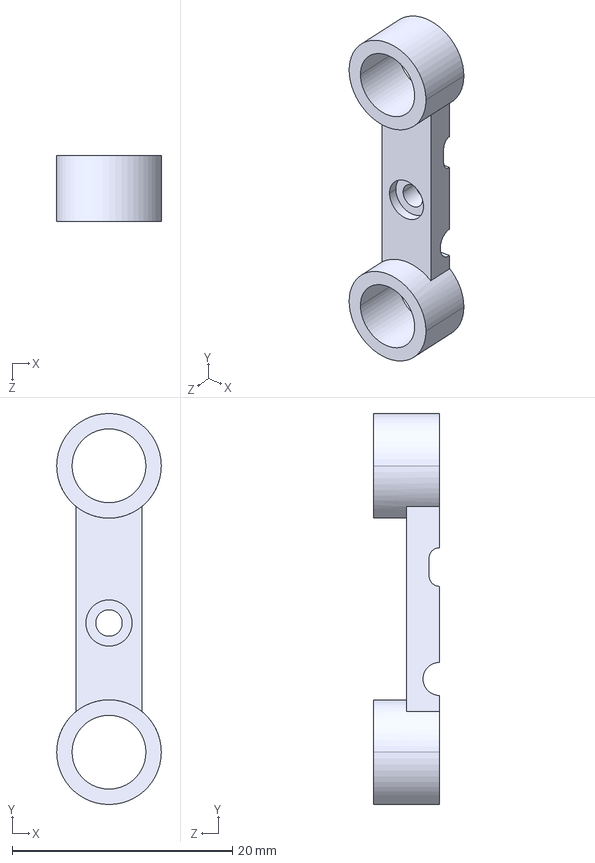
[picture p38: CAD file, 2026-10-30]
CAD/Prints/clamp_x_2_top.STEP
9.50 x 35.5 x 6.00 mm
