nasianikolova/Cubi-2/CAD/Prints/clamp_x_2.STEP

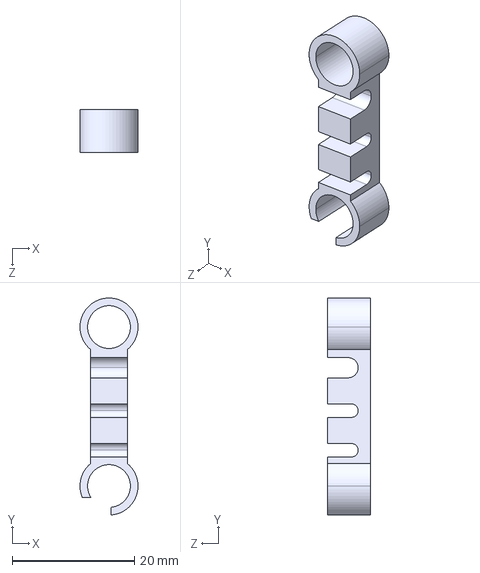
[picture p39: CAD file, 2026-10-30]
CAD/Prints/clamp_x_2.STEP
9.50 x 35.5 x 7.00 mm
