nasianikolova/Cubi-2/CAD/Prints/battery_top_standoff.STEP

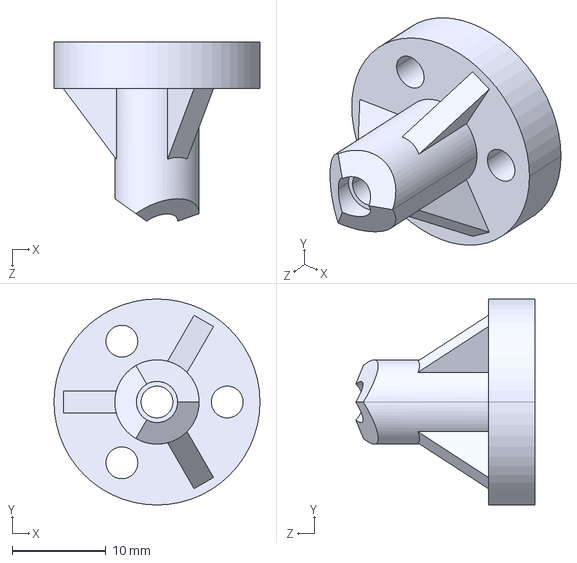
[picture p40: CAD file, 2026-10-30]
CAD/Prints/battery_top_standoff.STEP
22.0 x 22.0 x 19.2 mm
