nasianikolova/Cubi-2/CAD/Prints/battery_tube.STEP

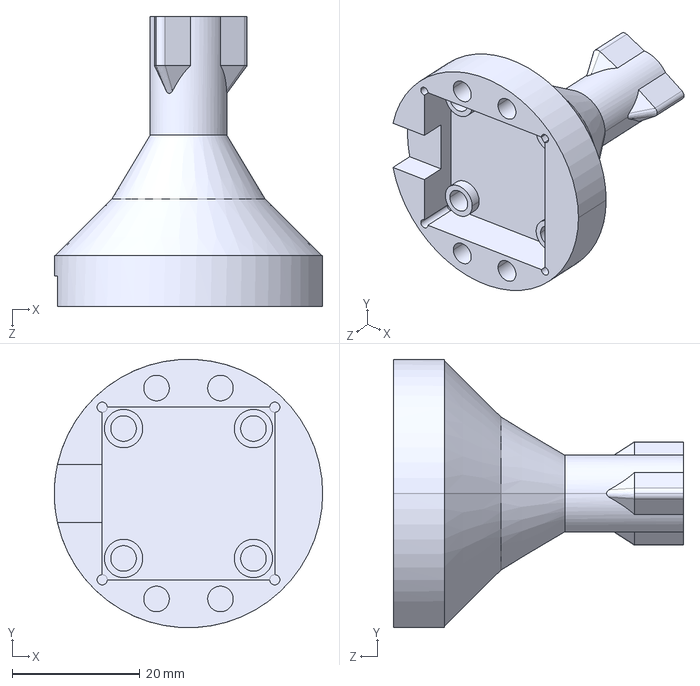
[picture p41: CAD file, 2026-10-30]
CAD/Prints/battery_tube.STEP
42.0 x 41.9 x 45.4 mm
