nasianikolova/Cubi-2/CAD/Prints/clamp_x_1.step

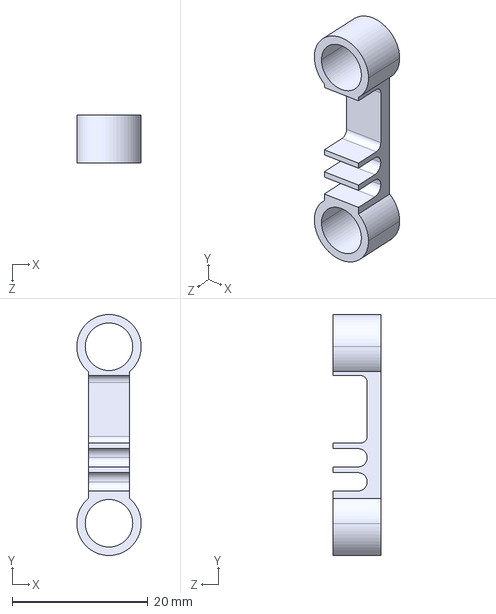
[picture p42: CAD file, 2026-10-30]
CAD/Prints/clamp_x_1.step
9.50 x 35.5 x 7.00 mm
