nasianikolova/Cubi-2/CAD/Prints/magnet-handler.step

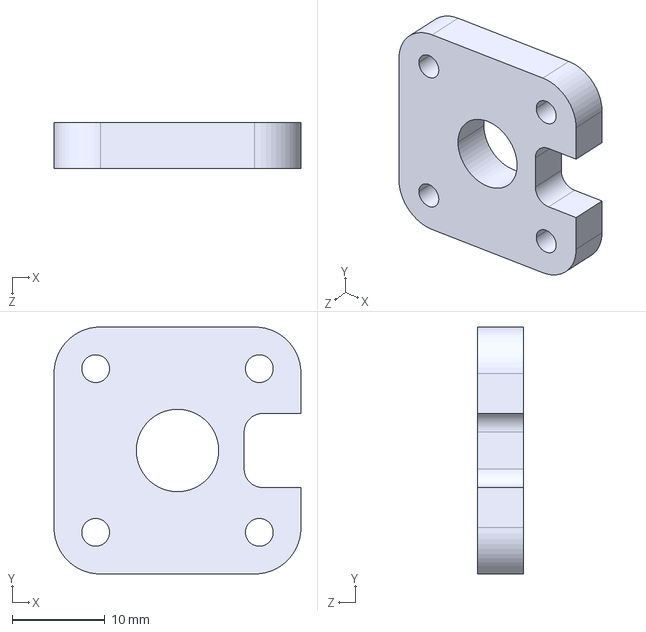
[picture p43: CAD file, 2026-10-30]
CAD/Prints/magnet-handler.step
26.7 x 26.7 x 5.00 mm
