nasianikolova/Cubi-2/CAD/Prints/clamp_x_1_base.STEP

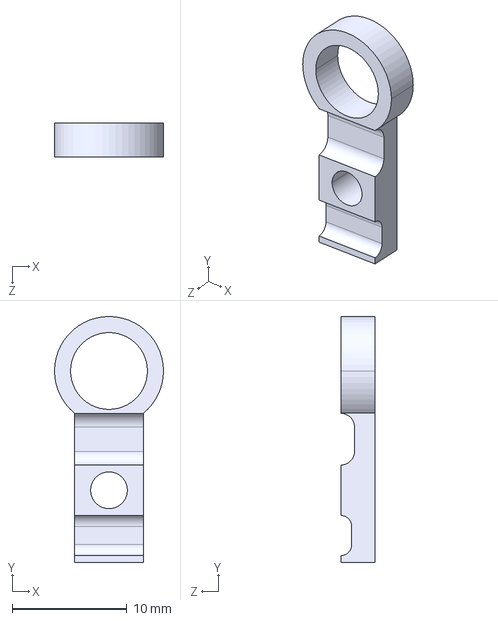
[picture p44: CAD file, 2026-10-30]
CAD/Prints/clamp_x_1_base.STEP
9.50 x 21.4 x 3.00 mm
