nasianikolova/Cubi-2/CAD/Prints/cable_clamp_bar.STEP

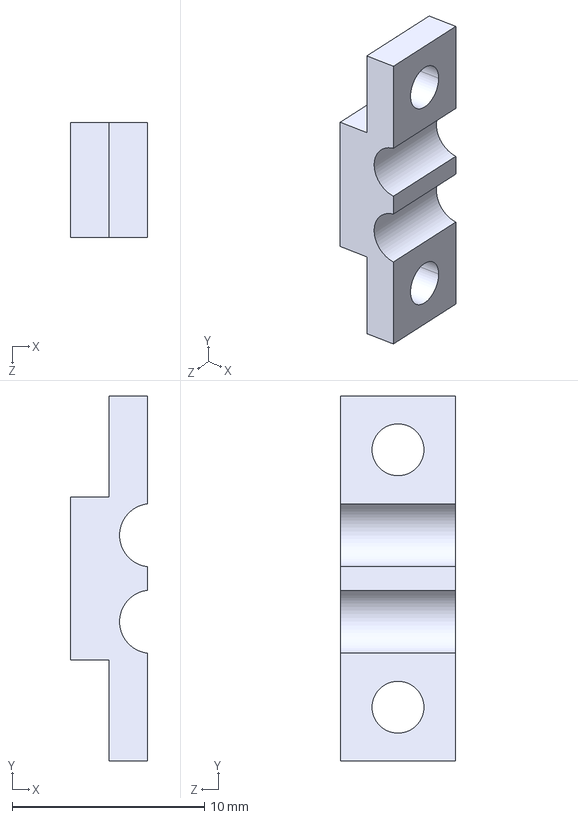
[picture p45: CAD file, 2026-10-30]
CAD/Prints/cable_clamp_bar.STEP
4.00 x 19.0 x 6.00 mm
