nasianikolova/Cubi-2/CAD/Prints/sphere_arc_diag_under.step

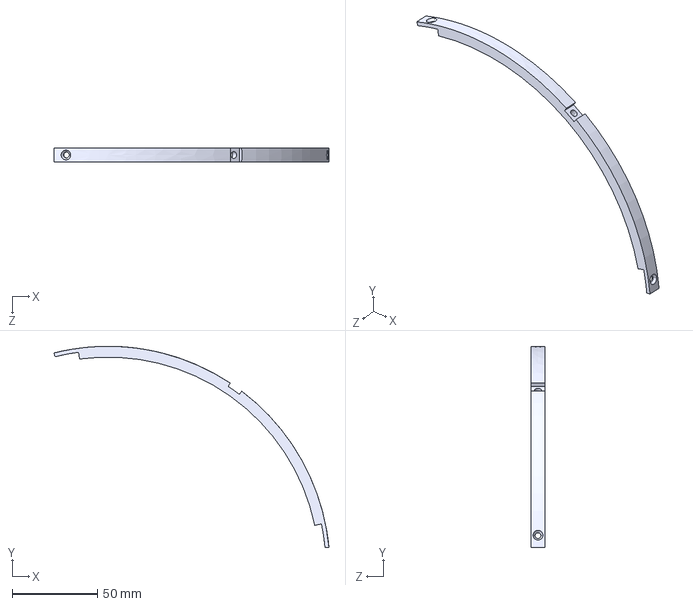
[picture p46: CAD file, 2026-10-30]
CAD/Prints/sphere_arc_diag_under.step
161.1 x 118.0 x 8.00 mm
