nasianikolova/Cubi-2/CAD/Prints/beam.STEP

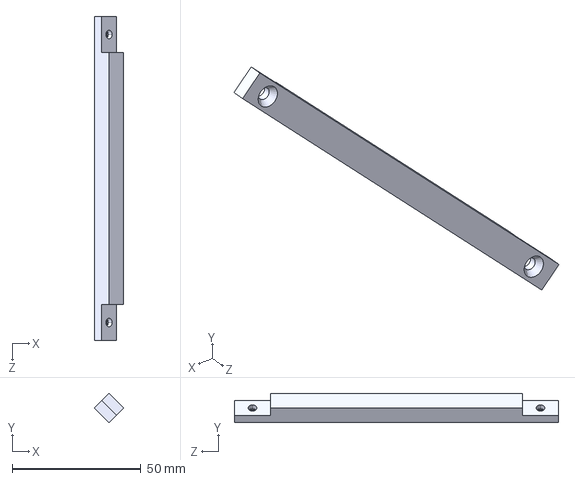
[picture p48: CAD file, 2026-10-30]
CAD/Prints/beam.STEP
11.3 x 11.3 x 126.0 mm
