nasianikolova/Cubi-2/(list of files, cad)

Other CAD files:
CAD/Prints/corner.STEP
CAD/Prints/clamp_z.step
CAD/Prints/sphere_connector.STEP
CAD/Prints/base_bottom.STL
CAD/Prints/base_top.STL
CAD/Prints/base_top_sphere.STL
CAD/Prints/battery_basin.STL
CAD/Prints/battery_top_standoff.STL
CAD/Prints/battery_tube.STL
CAD/Prints/beam.STL
CAD/Prints/beam_tie.STL
CAD/Prints/box.STL
CAD/Prints/box_standoff.STL
CAD/Prints/cable_clamp_bar.STL
CAD/Prints/clamp_power.STL
CAD/Prints/clamp_x_1.STL
CAD/Prints/clamp_x_1_base.STL
CAD/Prints/clamp_x_1_top.STL
CAD/Prints/clamp_x_2.STL
CAD/Prints/clamp_x_2_base.STL
CAD/Prints/clamp_x_2_top.STL
CAD/Prints/clamp_y.STL
CAD/Prints/clamp_y_base.STL
CAD/Prints/clamp_y_top.STL
CAD/Prints/clamp_z.STL
CAD/Prints/clamp_z_base.STL
CAD/Prints/clamp_z_top.STL
CAD/Prints/corner.STL
CAD/Prints/corner_b.STL
CAD/Prints/cover.STL
CAD/Prints/hang_plate.STL
CAD/Prints/magnet-handler.STL
CAD/Prints/magnet_carrier.STL
CAD/Prints/navel.STL
CAD/Prints/reaction_wheel.STL
CAD/Prints/spacer_OD6_ID3.2_H1.STL
CAD/Prints/spacer_OD6_ID3.2_H4.STL
CAD/Prints/spacer_OD9.5_ID7_H2.STL
CAD/Prints/sphere_arc_diag_over.STL
CAD/Prints/sphere_arc_diag_under.STL
CAD/Prints/sphere_arc_edge.STL
CAD/Prints/sphere_connector.STL
