nasianikolova/Cubi-2/Documents/cubi2_version_history.pdf

## Version history

All the documents share one version: v1.2, November 2026

### Versions (newest first)

version | date | what changed

### 1.2 November

| 2026 | Clear print for every reader: text at 14 pt (nothing under 12 pt), tagged PDF for screen readers, a text alternative for every picture, steps called by name, the app from GitHub.

1.1 October 2026 Start-up Guide - Bring Cubi to Life (programs,
| | settings, first balance). CAN wire colors as printed on the drivers.

### 1.0 September

| 2026 | First release: lists, inserts, boards, magnets, wiring, assembly and printing guides.

### The documents

document | | what it is
Materials | components, electronics, cables, fasteners, printed
| | parts - everything for one Cubi 2
Inserts guide | heat-set inserts, step by step, where each goes
Boards guide | how the electrics work, then the 3 boards step by
| | step
Magnets guide | motor magnets with the magnet-handler, cover
| | magnets
Wiring guide | every wire in order, in the cable clamps
Assembly guide | the whole build, step by step, screws at real size
Printing guide | every printed part: on the bed, color, settings,
| | grams

Start-up Guide:

Bring Cubi to Life

| | the programs, the settings, the first balance

document | what it is
SpaceInClass - Cubi 2, Project Brief | SpaceInClass and its first project, for a quick read

Wishlist for the next

upgrade

what the build and the tests taught

SpaceInClass - Cubi

### 2 slides

the presentation, from the slides of 15 Oct 2026

Cubi 2 - the science the physics, the control loop, the results, in short

Maker Portfolio | MIT: one JPG per slot at full size, and the texts to
| paste
SpaceInClass · Cubi 2 · Athanasia Nikolova | 2 / 2
