nasianikolova/Cubi-2/(commit log)

2026-10-10 step files added
    [battery_basin.STEP, battery_basin.step, battery_top_standoff.STEP, battery_top_standoff.step, battery_tube.STEP, battery_tube.step, beam.STEP, beam.step]
2026-10-10 Box and open frame parts
    [beam.STEP, beam_tie.STEP, box.STEP, corner.STEP]
2026-10-10 Box and open Frame
    [corner.STEP]
2026-10-10 board_x added
    [board_x.STEP]
2026-10-10 stl files added
    [beam.STL, beam_tie.STL, box.STL, corner.STL]
2026-10-10 basin added
    [battery_basin.STEP, battery_basin.STL, box.STEP, box.STL]
2026-10-11 battery holders
    [battery_top_standoff.STEP, battery_top_standoff.STL, battery_tube.STEP, battery_tube.STL, box_standoff.STEP, box_standoff.STL, cable_clamp_bar.STEP, cable_clamp_bar.STL]
2026-10-13 breadth changing of basin
    [battery_basin.STEP]
2026-10-13 box_standoff update
    [box_standoff.STEP]
2026-10-13 spacer uploaded
    [spacer_OD6_ID3.2_H4.STEP]
2026-10-13 stl spacer uploaded
    [spacer_OD6_ID3.2_H4.STL]
2026-10-15 clamps x and z top
    [clamp_x_1_top.STEP, clamp_x_1_top.STL, clamp_z_top.STEP, clamp_z_top.STL]
2026-10-15 clamps y and z base
    [clamp_y_base.STEP, clamp_y_base.STL, clamp_z_base.STEP, clamp_z_base.STL]
2026-10-15 clamps x and y top
    [clamp_x_2_top.STEP, clamp_x_2_top.STL, clamp_y_top.STEP, clamp_y_top.STL]
2026-10-15 clamps x base
    [clamp_x_1_base.STEP, clamp_x_1_base.STL, clamp_x_2_base.STEP, clamp_x_2_base.STL]
2026-10-15 clamp power
    [clamp_power.STEP, clamp_power.STL]
2026-10-18 reaction wheels STEP and STL
    [reaction_wheel.STEP, reaction_wheel.STL, spacer_OD6_ID3.2_H4.STEP]
2026-10-18 magnet carrier STEP and STL
    [magnet_carrier.STEP, magnet_carrier.STL]
2026-10-18 sphere connectors STEP and STL
    [sphere_connector.STEP, sphere_connector.STL]
2026-10-18 arc STEP and STL
    [sphere_arc_edge.STEP, sphere_arc_edge.STL]
2026-10-18 board z
    [board_z.STEP]
2026-10-18 board x updated
    [board_x.STEP]
2026-10-29 board y
    [board_x.STEP, board_y.STEP]
2026-10-29 TX60 parts
    [bconn_female.STEP, bconn_male.STEP]
2026-10-29 teense 4.1
    [mcu.STEP]
2026-10-29 controller and motor
    [motor.STEP, motor_driver.STEP]
2026-10-29 prototyping perfoboard
    [perfboard.STEP]
2026-10-30 updated files
    [base_bottom.STEP, base_bottom.STL, base_top.STEP, base_top.STL, base_top_sphere.STEP, base_top_sphere.STL, battery_basin.STEP, battery_basin.STL]
